apws/261103-reto-comp-andrew-grok-kicad/docs/images/261105-01 tell the agent - use tscircuit - Screenshot_20261105_011434.png

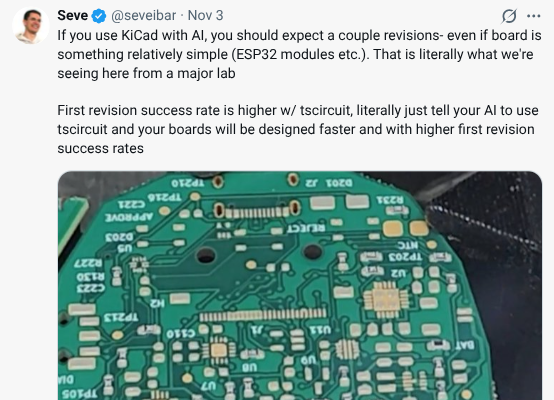
docs/images/261105-01 tell the agent - use tscircuit - Screenshot_20261105_011434.png
