apws/261103-reto-comp-andrew-grok-kicad/docs/images/261103-2328 first schematic -- Screenshot_20261103_232820.png

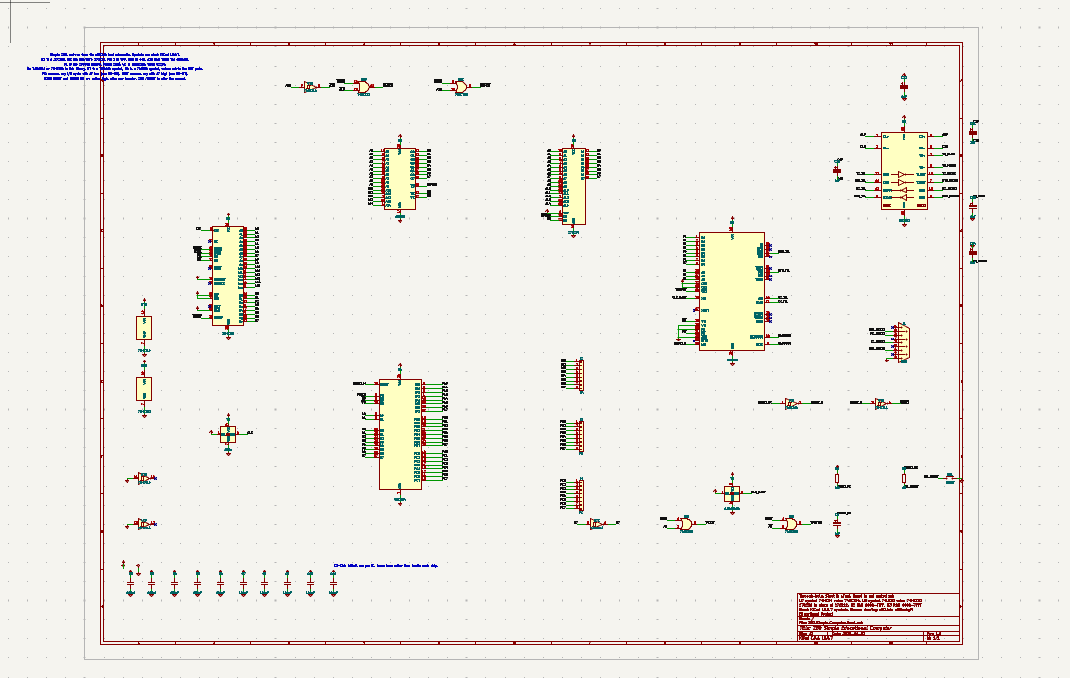
docs/images/261103-2328 first schematic -- Screenshot_20261103_232820.png
