apws/261103-reto-comp-andrew-grok-kicad/docs/images/261104-0004 very hard for grok only to relayout the sheet QQQ -- Screenshot_20261104_000429.png

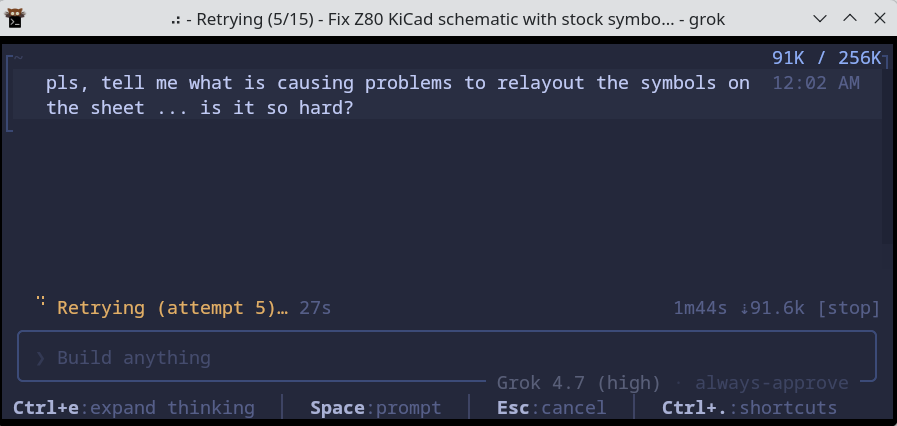
docs/images/261104-0004 very hard for grok only to relayout the sheet QQQ -- Screenshot_20261104_000429.png
