apws/261103-reto-comp-andrew-grok-kicad/docs/images/261104-0042 schematic relayout, but still large A2 sheet QQ -- Screenshot_20261104_004217.png

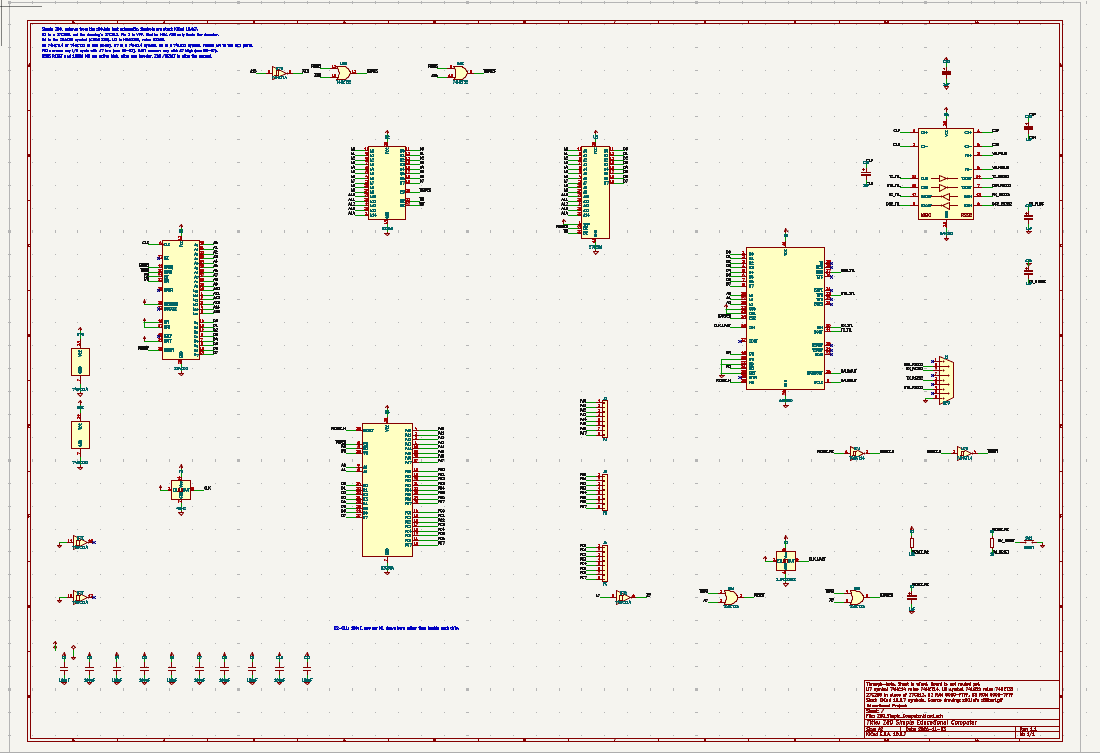
docs/images/261104-0042 schematic relayout, but still large A2 sheet QQ -- Screenshot_20261104_004217.png
