apws/261103-reto-comp-andrew-grok-kicad/docs/images/261105-00 implementing the placement and routing plan, it started but - out of weekly limit.png

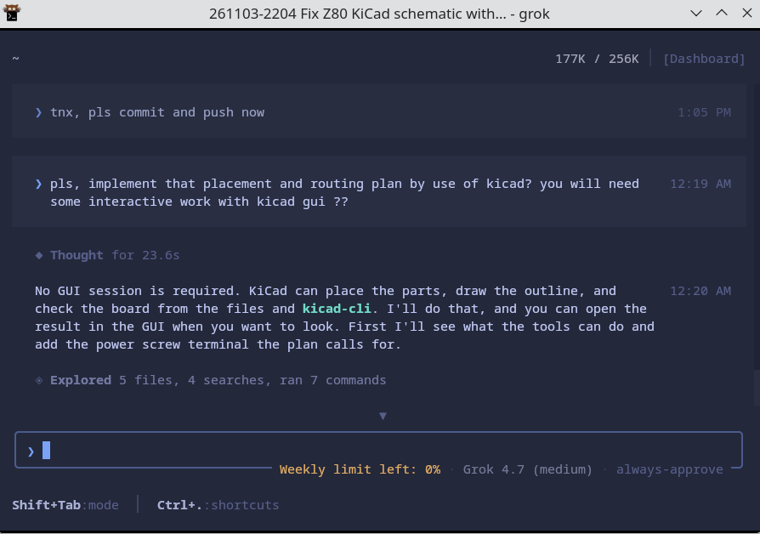
docs/images/261105-00 implementing the placement and routing plan, it started but - out of weekly limit.png
