apws/261103-reto-comp-andrew-grok-kicad/docs/images/261106-03 grok 2nd placement and 3d models in -- Screenshot_20261106_030632.png

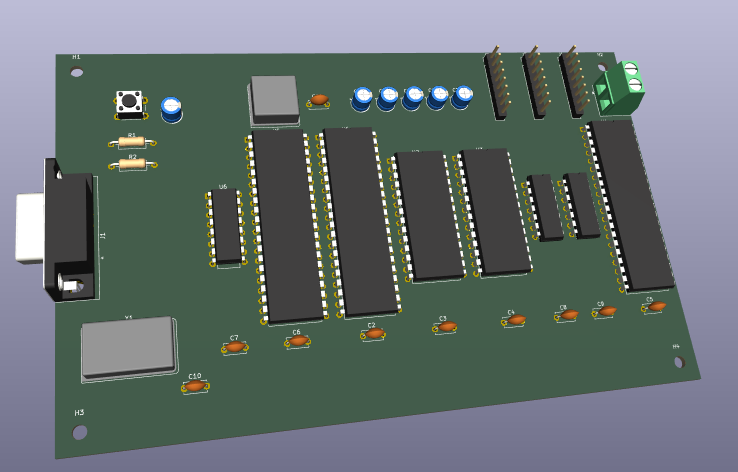
docs/images/261106-03 grok 2nd placement and 3d models in -- Screenshot_20261106_030632.png
