apws/261103-reto-comp-andrew-grok-kicad/docs/images/261106-18a google agy lauch, auth (free on google-android account QQ) -- Screenshot_20261106_190007.png

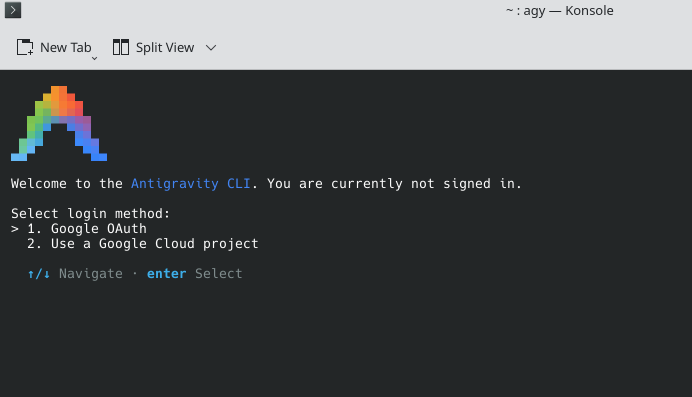
docs/images/261106-18a google agy lauch, auth (free on google-android account QQ) -- Screenshot_20261106_190007.png
