apws/261103-reto-comp-andrew-grok-kicad/docs/images/261106-18b google agy logged in -- Screenshot_20261106_190125.png

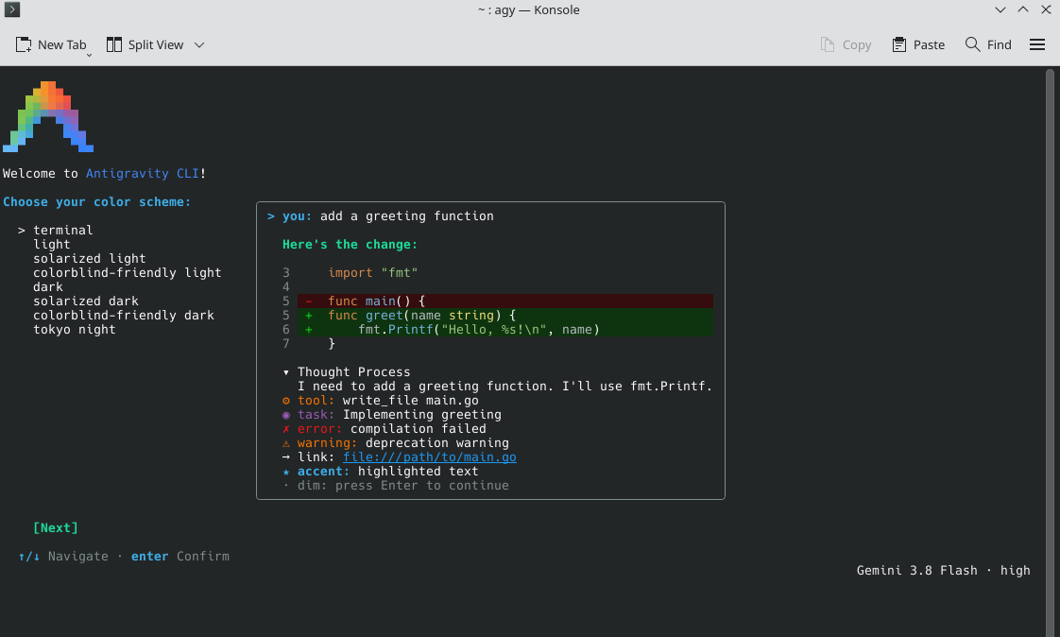
docs/images/261106-18b google agy logged in -- Screenshot_20261106_190125.png
