apws/261103-reto-comp-andrew-grok-kicad/docs/images/261106-18c google agy logged in - next config  -- Screenshot_20261106_190250.png

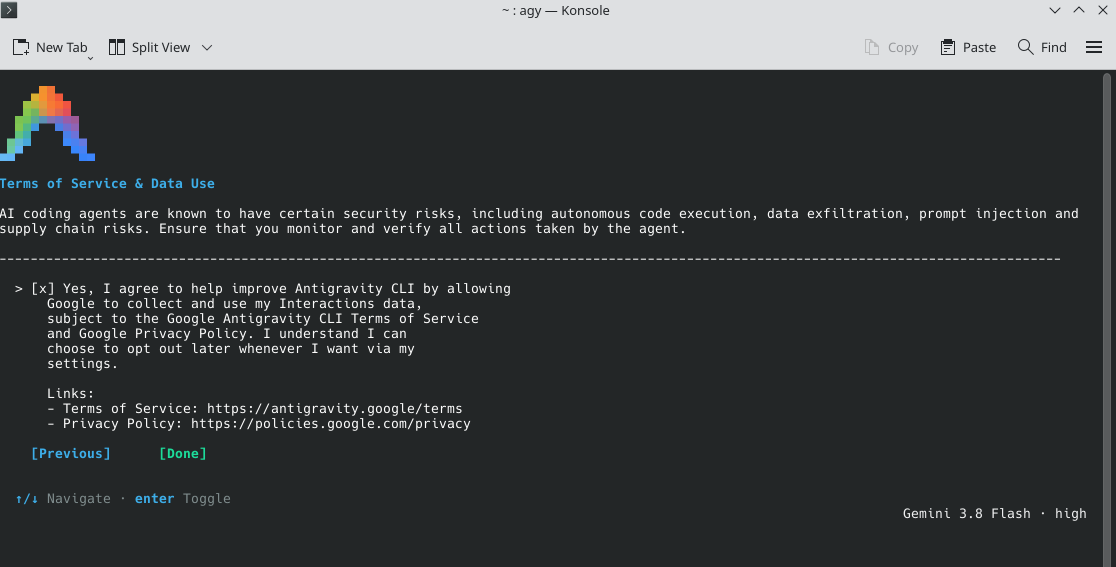
docs/images/261106-18c google agy logged in - next config -- Screenshot_20261106_190250.png
