apws/261103-reto-comp-andrew-grok-kicad/docs/images/261106-21 bottom pcb sawtooth clearance hug -- Screenshot_20261106_2139.png

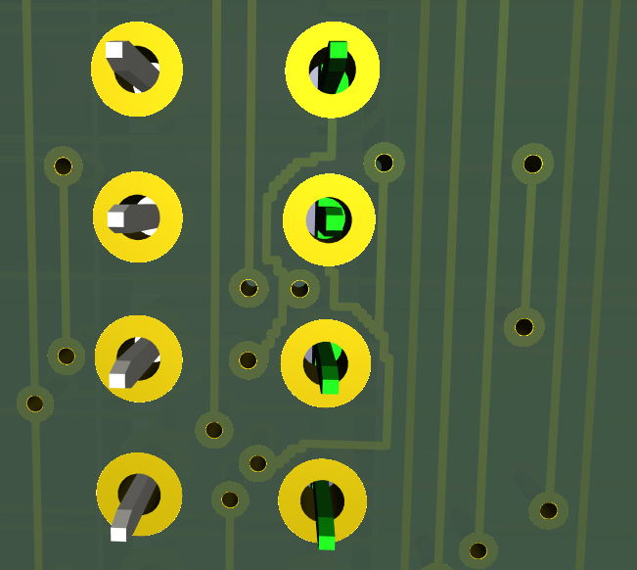
docs/images/261106-21 bottom pcb sawtooth clearance hug -- Screenshot_20261106_2139.png
