apws/261103-reto-comp-andrew-grok-kicad/docs/images/!! feilipu cpm-ide ek 8085+acia -- Screenshot_20261103_222529.png

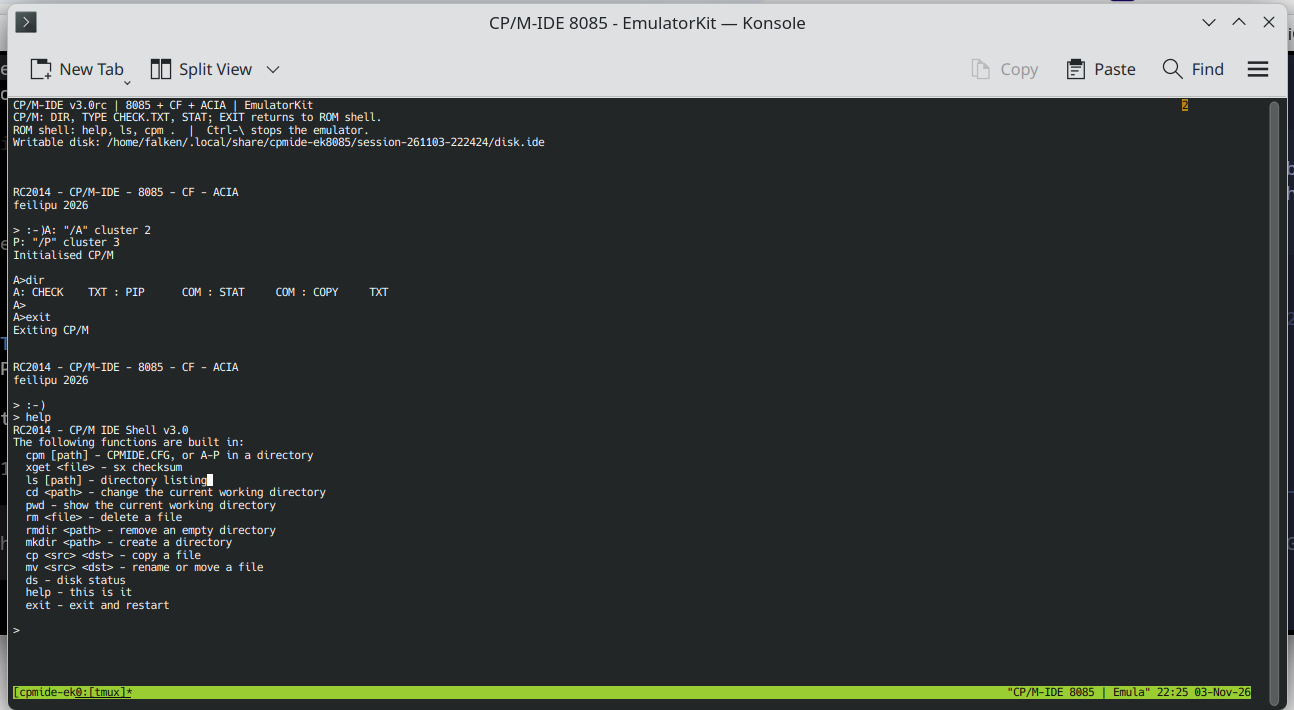
docs/images/!! feilipu cpm-ide ek 8085+acia -- Screenshot_20261103_222529.png
