apws/261103-reto-comp-andrew-grok-kicad/docs/images/!!! feilipu 8085 using EK + andrew kicad in grok - Screenshot_20261103_222328.png

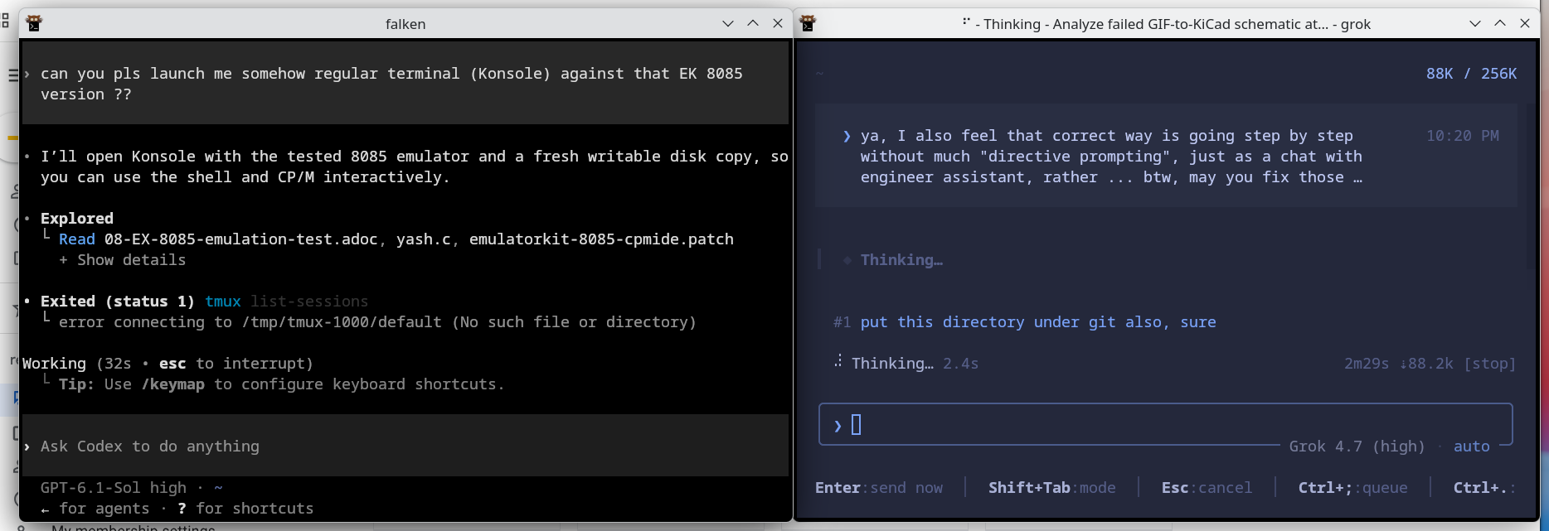
docs/images/!!! feilipu 8085 using EK + andrew kicad in grok - Screenshot_20261103_222328.png
