apws/261103-reto-comp-andrew-grok-kicad/docs/images/!!! grok in kitty, authorized by web over X -- Screenshot_20261103_220742.png

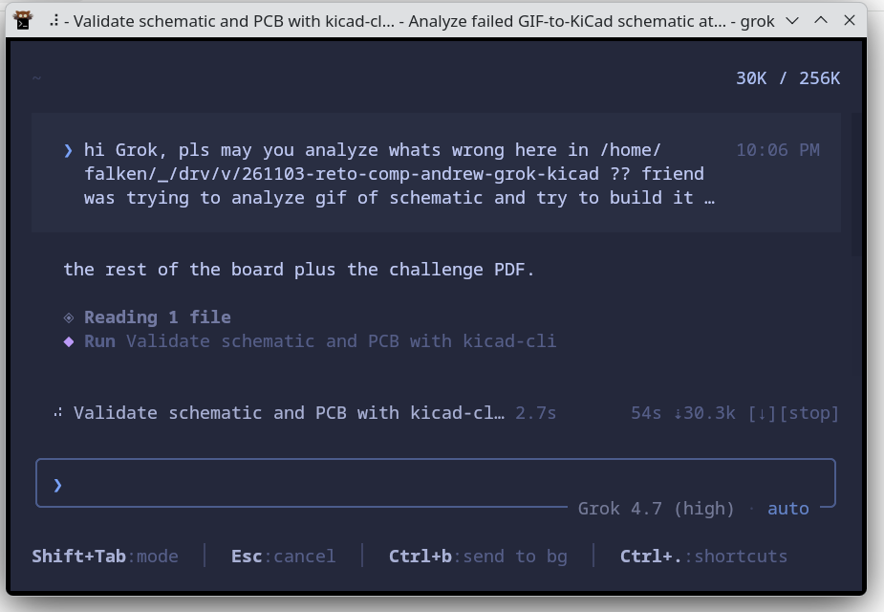
docs/images/!!! grok in kitty, authorized by web over X -- Screenshot_20261103_220742.png
