apws/261103-reto-comp-andrew-grok-kicad/docs/images/261106-18 google antigravity agy install linux -- Screenshot_20261106_185919.png

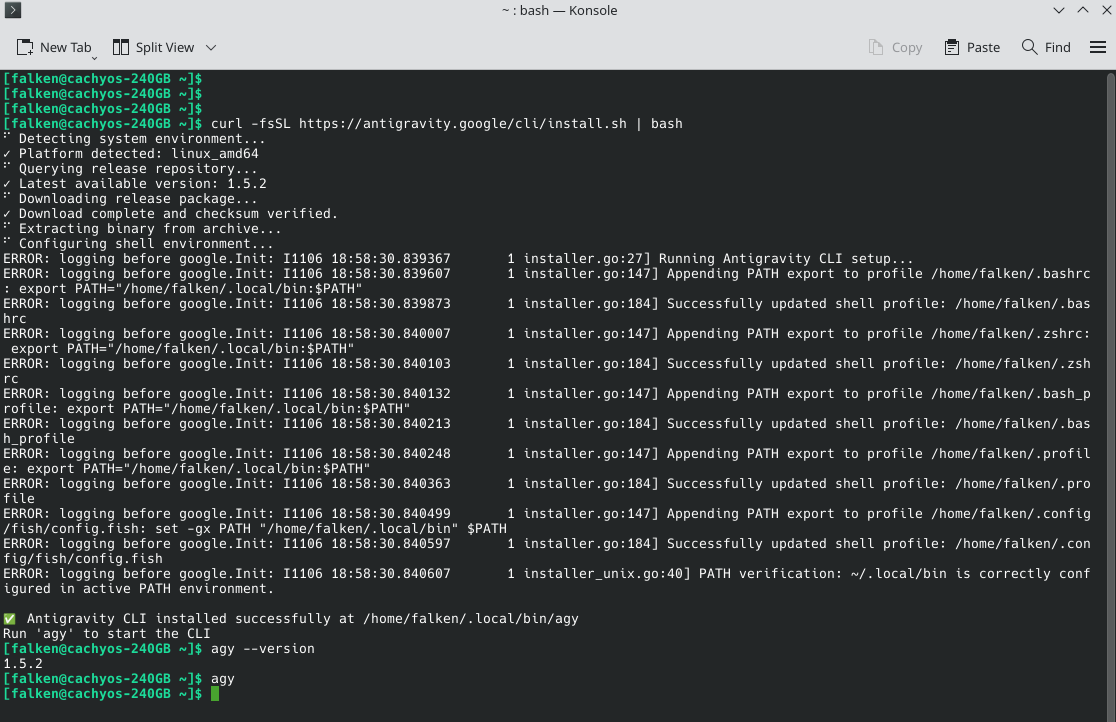
docs/images/261106-18 google antigravity agy install linux -- Screenshot_20261106_185919.png
