apws/261103-reto-comp-andrew-grok-kicad/docs/images/261106-21 google agy - Andrews board routing result (4 layer) - Screenshot_20261106_214348.png

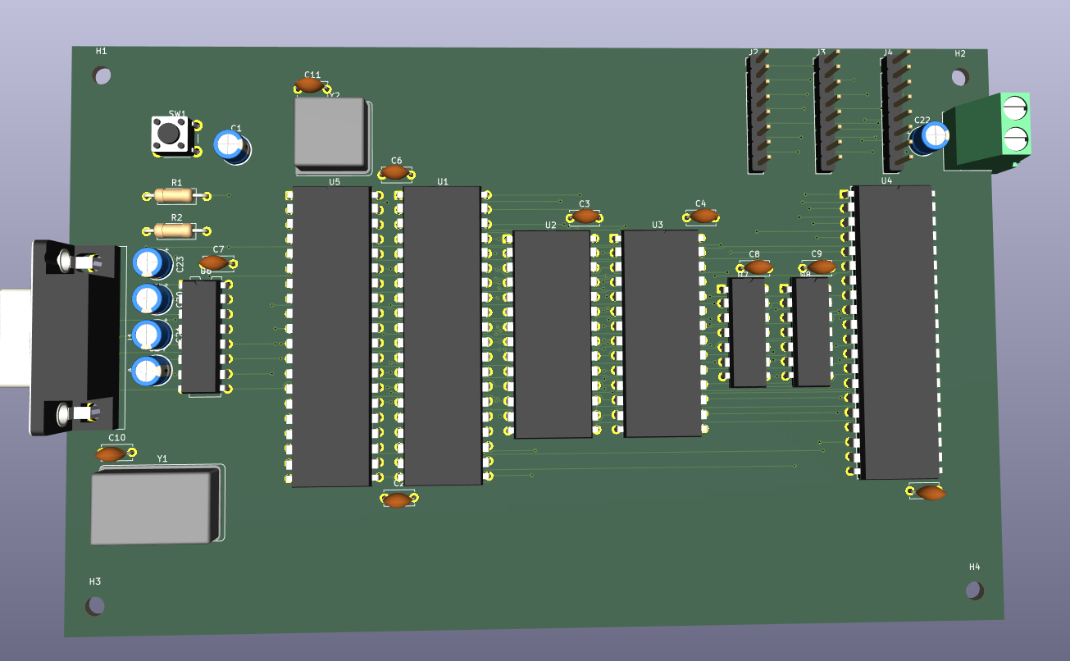
docs/images/261106-21 google agy - Andrews board routing result (4 layer) - Screenshot_20261106_214348.png
