apws/261103-reto-comp-andrew-grok-kicad/out/261105-00 schema, pcb print/261105-00 schema.pdf

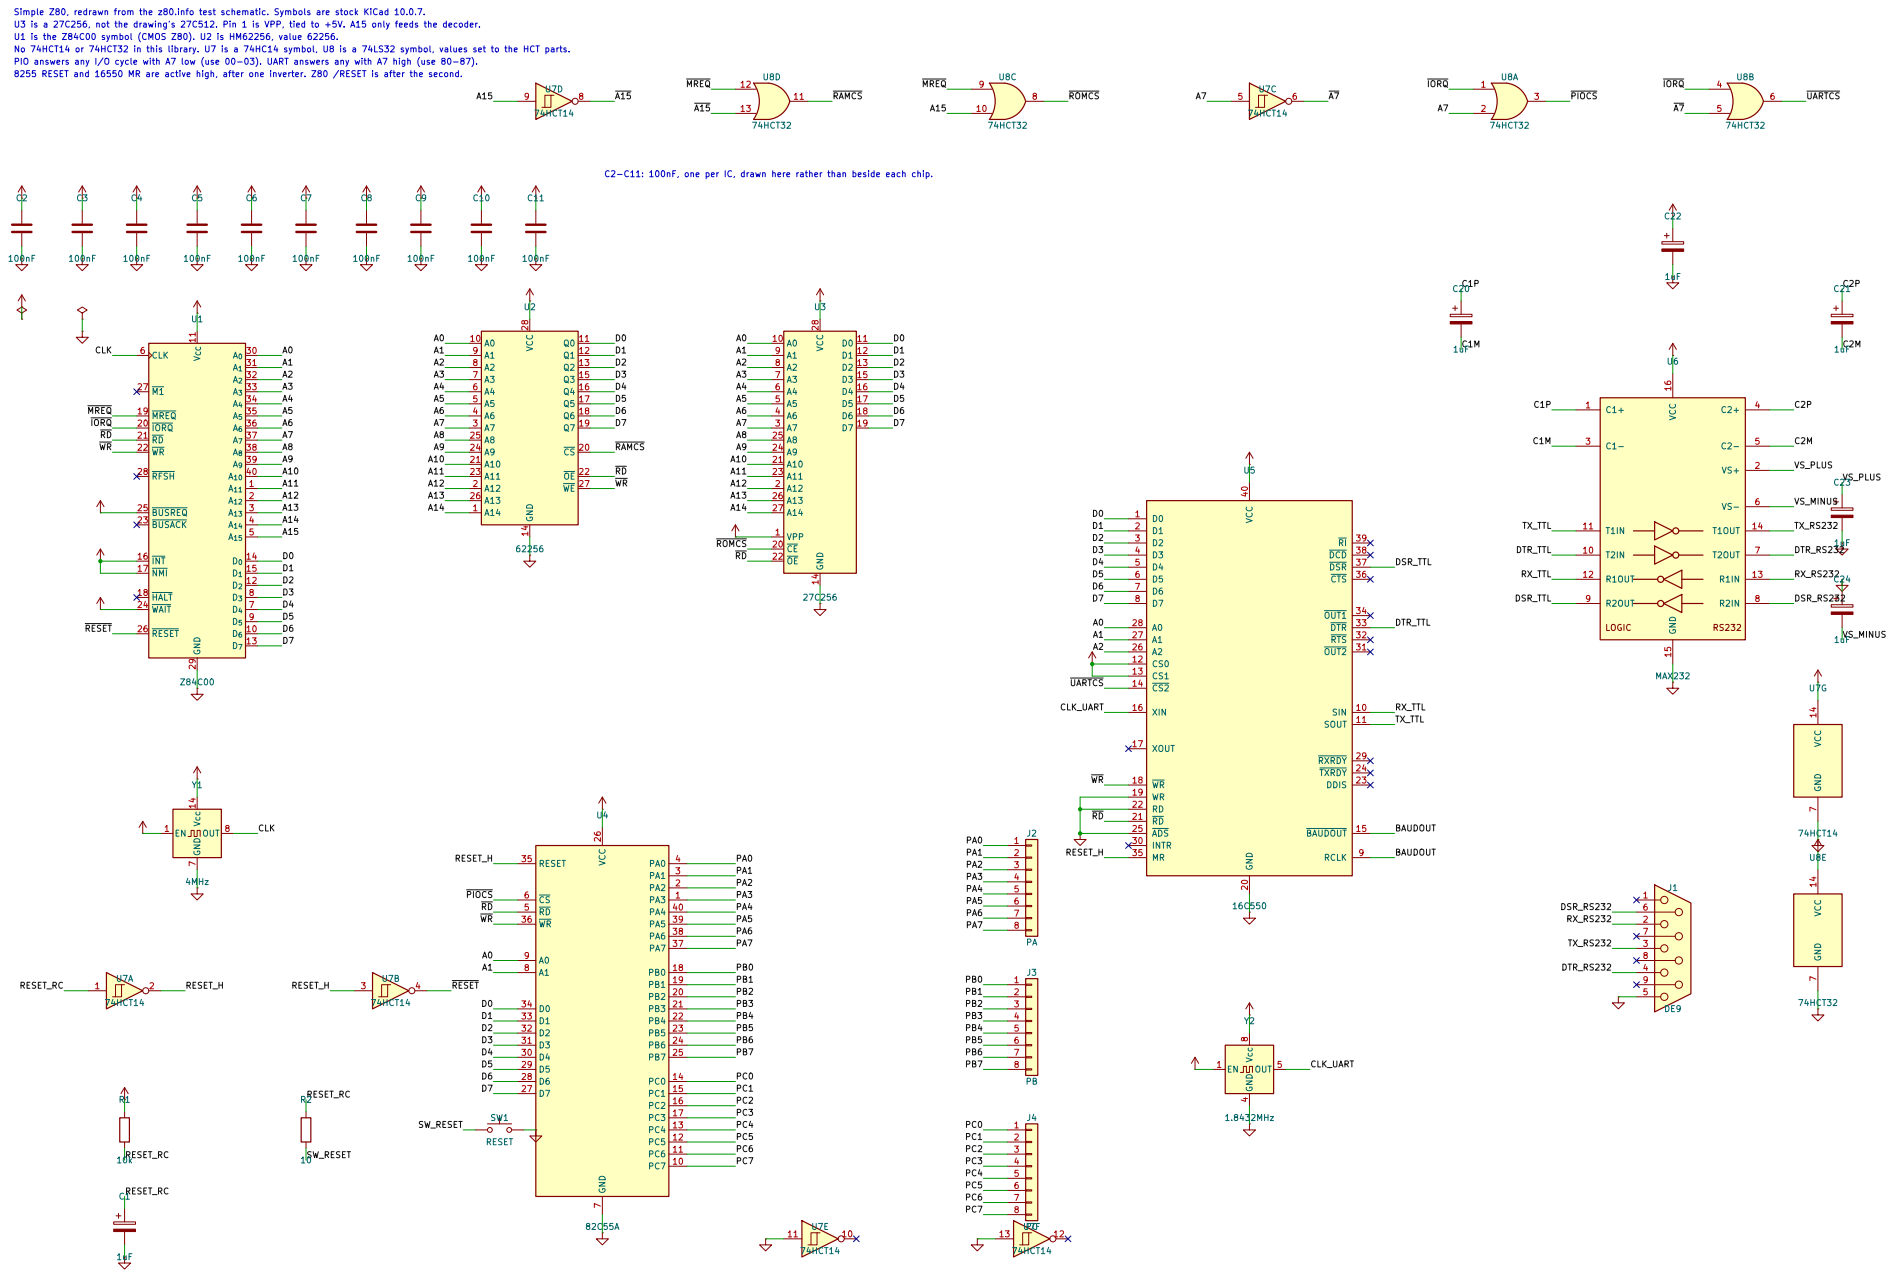
[picture p29: page 1]
