apws/261103-reto-comp-andrew-grok-kicad/Z80_Simple_Computer.kicad_pcb

## KiCad design Z80_Simple_Computer.kicad_pcb (2026-11-06)

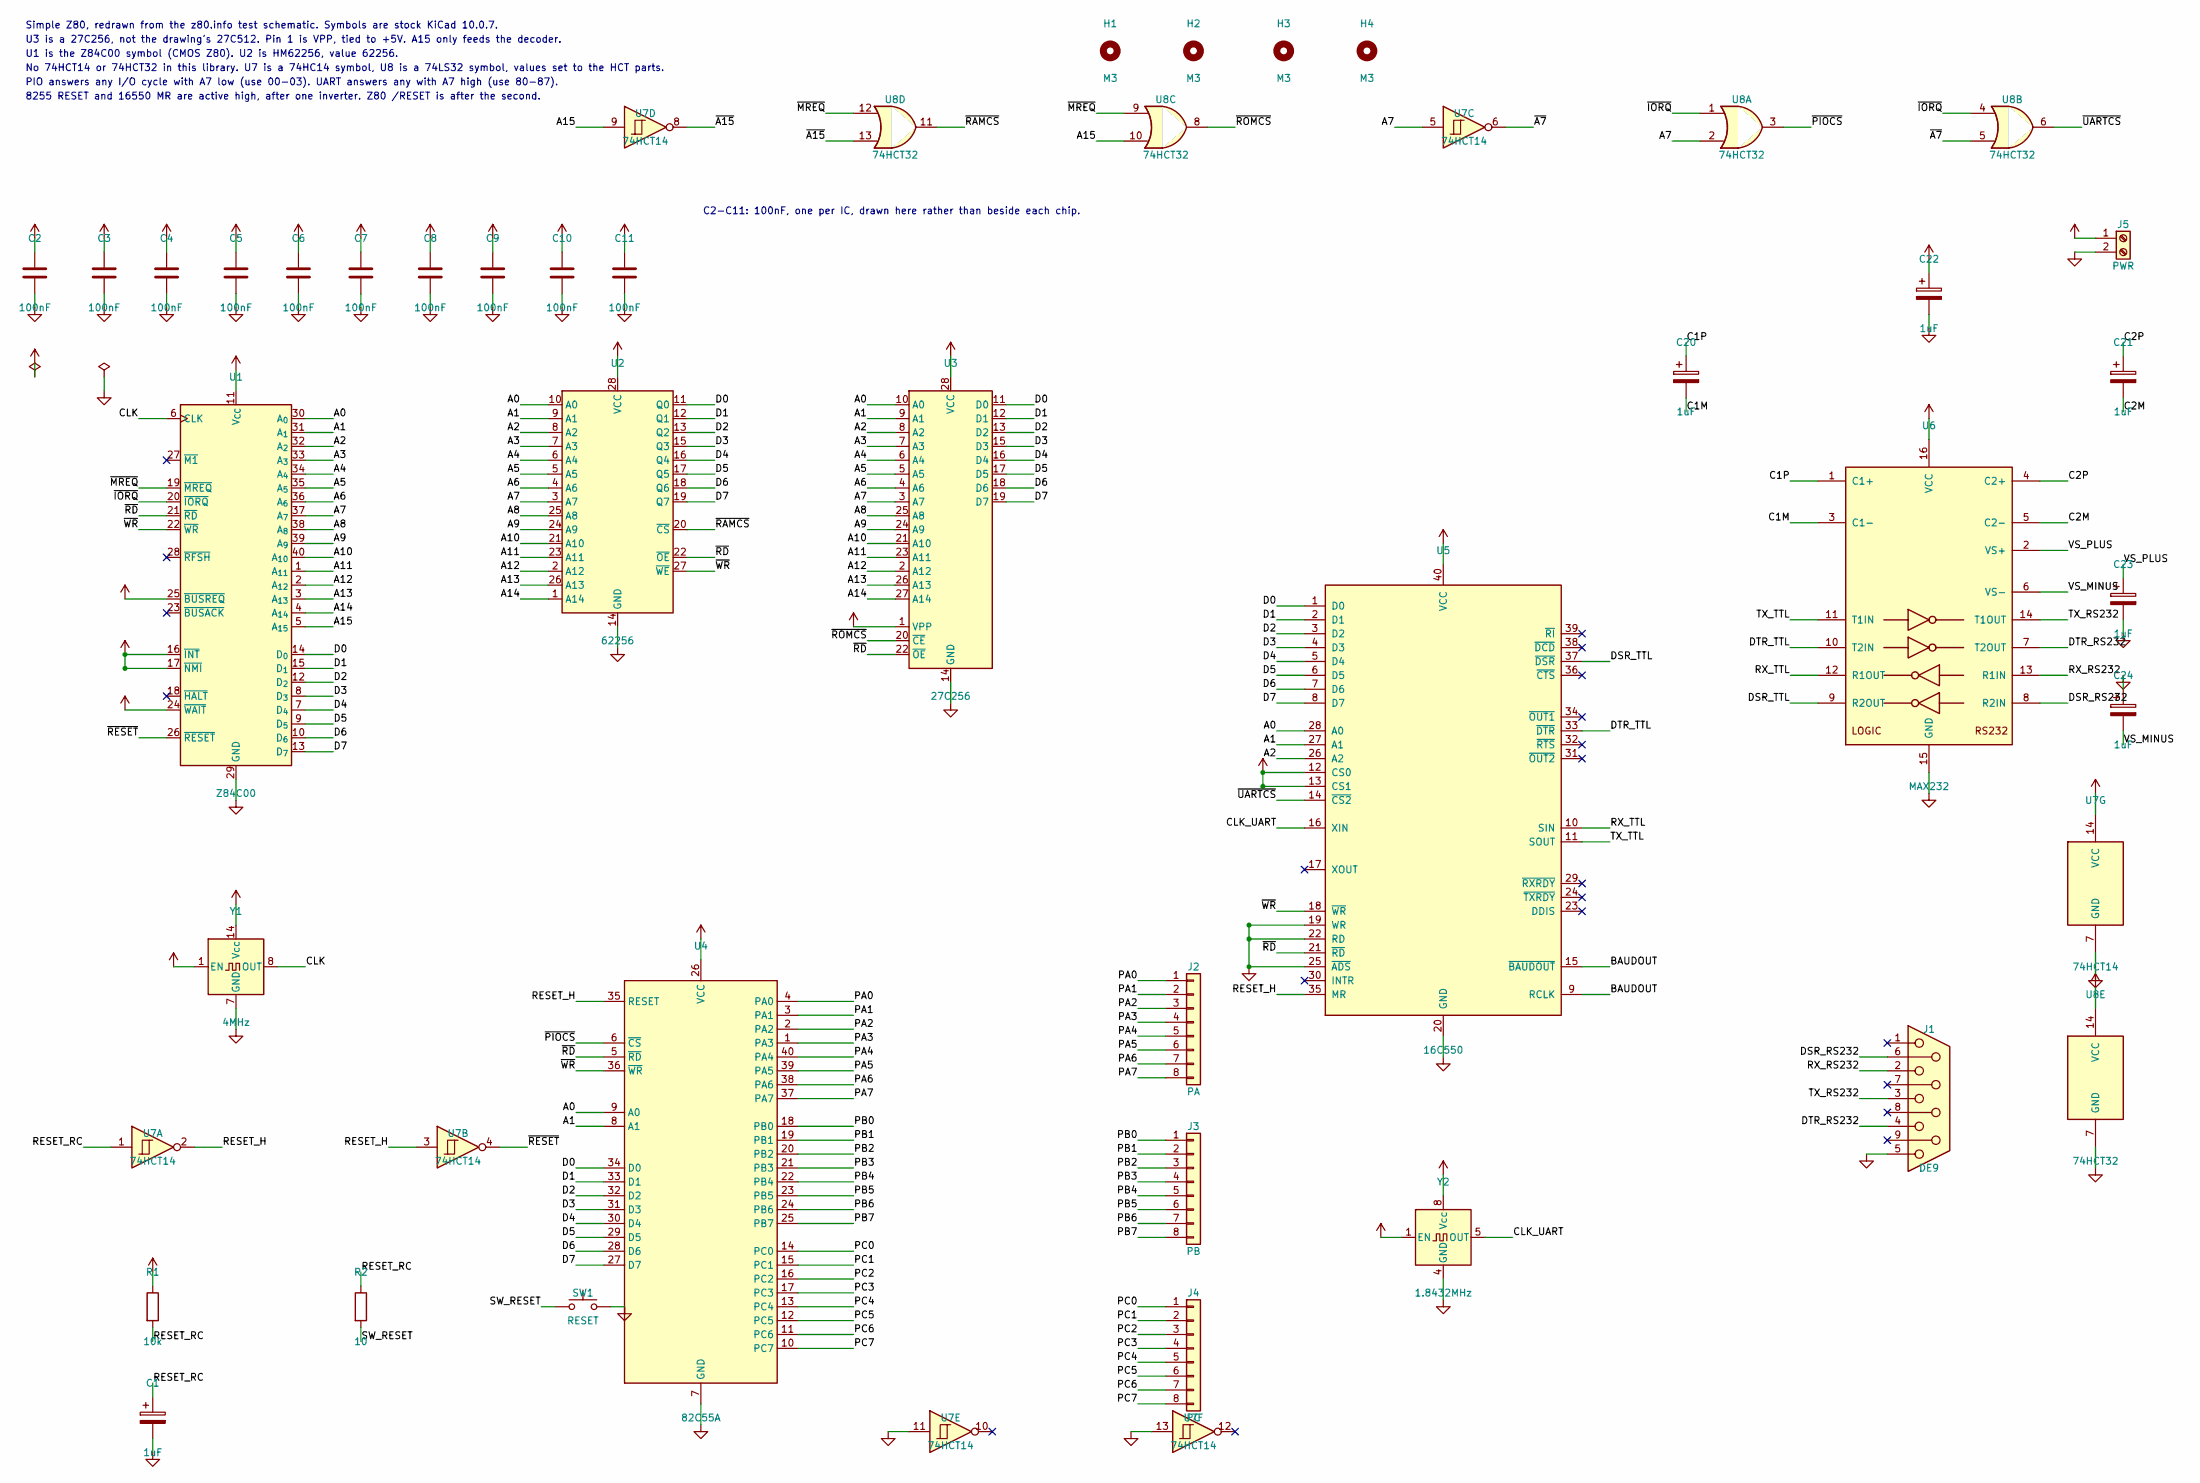
[picture p30: schematic Z80_Simple_Computer.kicad_sch, Z80 Simple Educational Computer]

Parts:
C1, C20, C21, C22, C23, C24: 1uF; CP_Radial_D5.0mm_P2.50mm
C2, C3, C4, C5, C6, C7, C8, C9, C10, C11: 100nF; C_Disc_D5.0mm_W2.5mm_P5.00mm
H1, H2, H3, H4: M3; MountingHole_3.2mm_M3
J1: DE9; DSUB-9_Socket_Horizontal_P2.77x2.84mm_EdgePinOffset4.94mm_H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
J2: PA; PinHeader_1x08_P2.54mm_Vertical
J3: PB; PinHeader_1x08_P2.54mm_Vertical
J4: PC; PinHeader_1x08_P2.54mm_Vertical
J5: PWR; TerminalBlock_Phoenix_MKDS-1,5-2-5.08_1x02_P5.08mm_Horizont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
R1: 10k; R_Axial_DIN0207_L6.3mm_D2.5mm_P10.16mm_Horizontal
R2: 10; R_Axial_DIN0207_L6.3mm_D2.5mm_P10.16mm_Horizontal
SW1: RESET; SW_PUSH_6mm
U1: Z84C00; DIP-40_W15.24mm
U2: 62256; DIP-28_W15.24mm
U3: 27C256; DIP-28_W15.24mm
U4: 82C55A; DIP-40_W15.24mm
U5: 16C550; DIP-40_W15.24mm
U6: MAX232; DIP-16_W7.62mm
U7: 74HCT14; DIP-14_W7.62mm
U8: 74HCT32; DIP-14_W7.62mm
Y1: 4MHz; Oscillator_DIP-14
Y2: 1.8432MHz; Oscillator_DIP-8

Connections:
+5V: C2.1, C3.1, C4.1, C5.1, C6.1, C7.1, C8.1, C9.1, C10.1, C11.1, C22.1, J5.1, R1.1, U1.11 (V_{CC}), U1.16 (~INT), U1.17 (~NMI), U1.24 (~WAIT), U1.25 (~BUSREQ), U2.28 (VCC), U3.1 (VPP), U3.28 (VCC), U4.26 (VCC), U5.12 (CS0), U5.13 (CS1), U5.40 (VCC), U6.16 (VCC), U7.14 (VCC), U8.14 (VCC), Y1.1 (EN), Y1.14 (Vcc), Y2.1 (EN), Y2.8 (Vcc)
/A0: U1.30 (A_{0}), U2.10 (A0), U3.10 (A0), U4.9 (A0), U5.28 (A0)
/A1: U1.31 (A_{1}), U2.9 (A1), U3.9 (A1), U4.8 (A1), U5.27 (A1)
/A2: U1.32 (A_{2}), U2.8 (A2), U3.8 (A2), U5.26 (A2)
/A3: U1.33 (A_{3}), U2.7 (A3), U3.7 (A3)
/A4: U1.34 (A_{4}), U2.6 (A4), U3.6 (A4)
/A5: U1.35 (A_{5}), U2.5 (A5), U3.5 (A5)
/A6: U1.36 (A_{6}), U2.4 (A6), U3.4 (A6)
/A7: U1.37 (A_{7}), U2.3 (A7), U3.3 (A7), U7.5, U8.2
/A8: U1.38 (A_{8}), U2.25 (A8), U3.25 (A8)
/A9: U1.39 (A_{9}), U2.24 (A9), U3.24 (A9)
/A10: U1.40 (A_{10}), U2.21 (A10), U3.21 (A10)
/A11: U1.1 (A_{11}), U2.23 (A11), U3.23 (A11)
/A12: U1.2 (A_{12}), U2.2 (A12), U3.2 (A12)
/A13: U1.3 (A_{13}), U2.26 (A13), U3.26 (A13)
/A14: U1.4 (A_{14}), U2.1 (A14), U3.27 (A14)
/A15: U1.5 (A_{15}), U7.9, U8.10
/BAUDOUT: U5.9 (RCLK), U5.15 (~BAUDOUT)
/C1M: C20.2, U6.3 (C1-)
/C1P: C20.1, U6.1 (C1+)
/C2M: C21.2, U6.5 (C2-)
/C2P: C21.1, U6.4 (C2+)
/CLK: U1.6 (CLK), Y1.8 (OUT)
/CLK_UART: U5.16 (XIN), Y2.5 (OUT)
/D0: U1.14 (D_{0}), U2.11 (Q0), U3.11 (D0), U4.34 (D0), U5.1 (D0)
/D1: U1.15 (D_{1}), U2.12 (Q1), U3.12 (D1), U4.33 (D1), U5.2 (D1)
/D2: U1.12 (D_{2}), U2.13 (Q2), U3.13 (D2), U4.32 (D2), U5.3 (D2)
/D3: U1.8 (D_{3}), U2.15 (Q3), U3.15 (D3), U4.31 (D3), U5.4 (D3)
/D4: U1.7 (D_{4}), U2.16 (Q4), U3.16 (D4), U4.30 (D4), U5.5 (D4)
/D5: U1.9 (D_{5}), U2.17 (Q5), U3.17 (D5), U4.29 (D5), U5.6 (D5)
/D6: U1.10 (D_{6}), U2.18 (Q6), U3.18 (D6), U4.28 (D6), U5.7 (D6)
/D7: U1.13 (D_{7}), U2.19 (Q7), U3.19 (D7), U4.27 (D7), U5.8 (D7)
/DSR_RS232: J1.6, U6.8 (R2IN)
/DSR_TTL: U5.37 (~DSR), U6.9 (R2OUT)
/DTR_RS232: J1.4, U6.7 (T2OUT)
/DTR_TTL: U5.33 (~DTR), U6.10 (T2IN)
/PA0: J2.1, U4.4 (PA0)
/PA1: J2.2, U4.3 (PA1)
/PA2: J2.3, U4.2 (PA2)
/PA3: J2.4, U4.1 (PA3)
/PA4: J2.5, U4.40 (PA4)
/PA5: J2.6, U4.39 (PA5)
/PA6: J2.7, U4.38 (PA6)
/PA7: J2.8, U4.37 (PA7)
/PB0: J3.1, U4.18 (PB0)
/PB1: J3.2, U4.19 (PB1)
/PB2: J3.3, U4.20 (PB2)
/PB3: J3.4, U4.21 (PB3)
/PB4: J3.5, U4.22 (PB4)
/PB5: J3.6, U4.23 (PB5)
/PB6: J3.7, U4.24 (PB6)
/PB7: J3.8, U4.25 (PB7)
/PC0: J4.1, U4.14 (PC0)
/PC1: J4.2, U4.15 (PC1)
/PC2: J4.3, U4.16 (PC2)
/PC3: J4.4, U4.17 (PC3)
/PC4: J4.5, U4.13 (PC4)
/PC5: J4.6, U4.12 (PC5)
/PC6: J4.7, U4.11 (PC6)
/PC7: J4.8, U4.10 (PC7)
/RESET_H: U4.35 (RESET), U5.35 (MR), U7.2, U7.3
/RESET_RC: C1.1, R1.2, R2.1, U7.1
/RX_RS232: J1.2, U6.13 (R1IN)
/RX_TTL: U5.10 (SIN), U6.12 (R1OUT)
/SW_RESET: R2.2, SW1.1
/TX_RS232: J1.3, U6.14 (T1OUT)
/TX_TTL: U5.11 (SOUT), U6.11 (T1IN)
/VS_MINUS: C24.2, U6.6 (VS-)
/VS_PLUS: C23.1, U6.2 (VS+)
/~A7: U7.6, U8.5
/~A15: U7.8, U8.13
/~IORQ: U1.20 (~IORQ), U8.1, U8.4
/~MREQ: U1.19 (~MREQ), U8.9, U8.12
/~PIOCS: U4.6 (~CS), U8.3
/~RAMCS: U2.20 (~CS), U8.11
/~RD: U1.21 (~RD), U2.22 (~OE), U3.22 (~OE), U4.5 (~RD), U5.21 (~RD)
/~RESET: U1.26 (~RESET), U7.4
/~ROMCS: U3.20 (~CE), U8.8
/~UARTCS: U5.14 (~CS2), U8.6
/~WR: U1.22 (~WR), U2.27 (~WE), U4.36 (~WR), U5.18 (~WR)
GND: C1.2, C2.2, C3.2, C4.2, C5.2, C6.2, C7.2, C8.2, C9.2, C10.2, C11.2, C22.2, C23.2, C24.1, J1.5, J5.2, SW1.2, U1.29 (GND), U2.14 (GND), U3.14 (GND), U4.7 (GND), U5.19 (WR), U5.20 (GND), U5.22 (RD), U5.25 (~ADS), U6.15 (GND), U7.7 (GND), U7.11, U7.13, U8.7 (GND), Y1.7 (GND), Y2.4 (GND)

Notes on the sheet:
Simple Z80, redrawn from the z80.info test schematic. Symbols are stock KiCad 10.0.7.
U3 is a 27C256, not the drawing's 27C512. Pin 1 is VPP, tied to +5V. A15 only feeds the decoder.
U1 is the Z84C00 symbol (CMOS Z80). U2 is HM62256, value 62256.
No 74HCT14 or 74HCT32 in this library. U7 is a 74HC14 symbol, U8 is a 74LS32 symbol, values set to the HCT parts.
PIO answers any I/O cycle with A7 low (use 00-03). UART answers any with A7 high (use 80-87).
8255 RESET and 16550 MR are active high, after one inverter. Z80 /RESET is after the second.
C2-C11: 100nF, one per IC, drawn here rather than beside each chip.

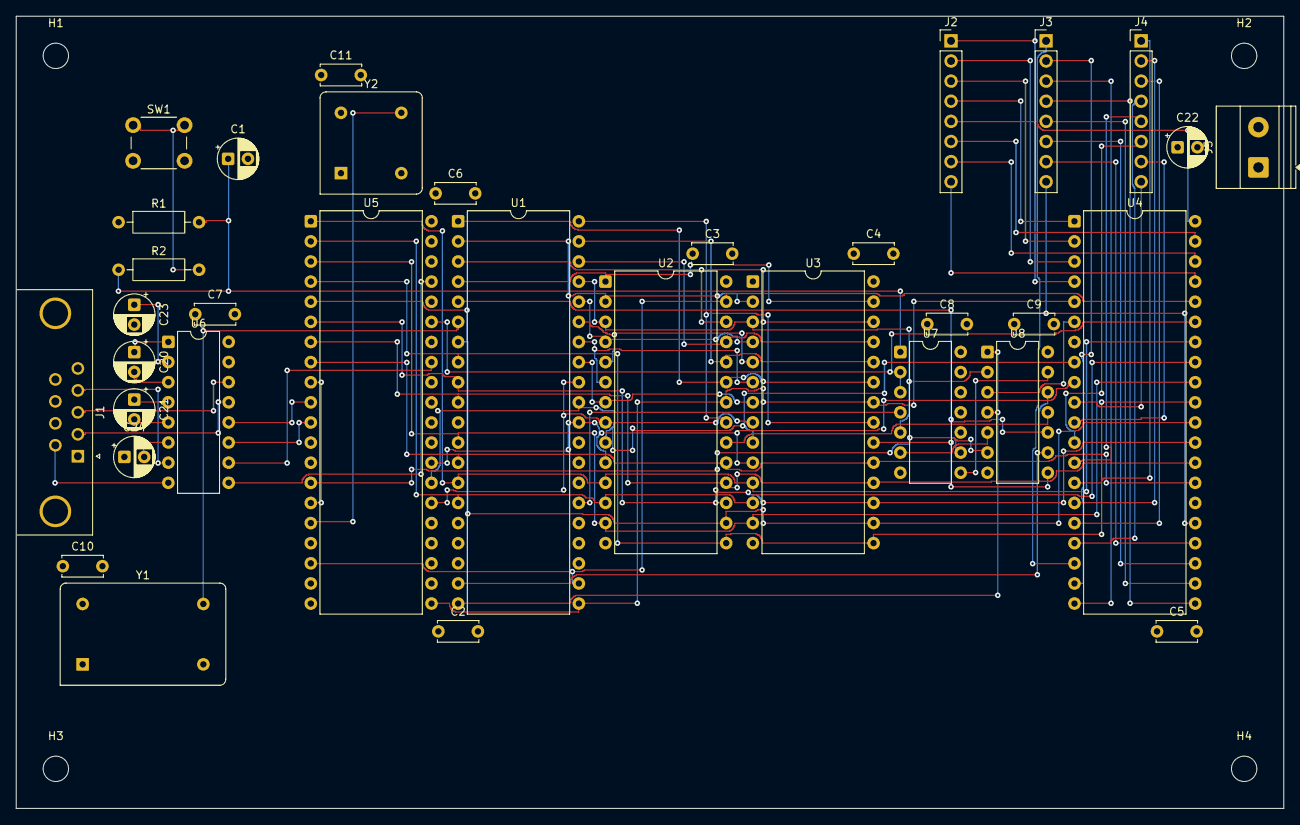
[picture p31: board Z80_Simple_Computer.kicad_pcb from above]

Board: 4 copper layers, 160.0 x 100.0 mm, 38 parts (0 on the bottom side), 81 nets.
