apws/261103-reto-comp-andrew-grok-kicad/(commit log)

2026-11-03 Track the Z80 sheet, the posted originals, and the notes.
    The schematic is rebuilt from stock KiCad 10.0.7 symbols and passes ERC.
    The board file is still the posted one and does not open.
    [Z80_Simple_Computer.kicad_pcb, Z80_Simple_Computer.kicad_sch]
2026-11-03 Say the board is still the posted file, and keep the fitted sheet.
    The schematic now sits inside the frame. The PCB has not been recreated
    and has to be steered one step at a time: size, layers, then placement.
    Notes live under docs/. The readme points at them and at the AsciiDoc preview.
    [Z80_Simple_Computer.kicad_sch]
2026-11-04 Save the KiCad 10 board KiCad wrote from the schematic.
    The project board is no longer the posted file that would not open.
    It has the 33 footprints, no board outline, and no tracks.
    The challenge PDF moves to as-posted/, and a new sheet screenshot is kept.
    KiCad's .history snapshots stay untracked.
    [Z80_Simple_Computer.kicad_pcb]
2026-11-04 Say the project board was recreated and updated from the schematic.
    It is not a repair of the posted file. That copy stays in as-posted/.
    The new board has the footprints only. Size, layers, and placement are still open.
2026-11-04 Record the board plan and the choices for the first trial.
    A4 sheet, Eurocard, four layers, a screw terminal for power, and hand
    routing in KiCad. The posted prompt file now lives with the other originals.
2026-11-04 Record the chat through the unfinished A3 page try.
    The transcript covers the board plan, the decisions, and the public repo.
    The A3 sheet is the first page step and still hangs off the paper.
    [Z80_Simple_Computer.kicad_sch]
2026-11-04 Fit the schematic on A3.
    A4 cannot hold the DIP-40 symbols. The same nets now sit inside the A3 frame.
    [Z80_Simple_Computer.kicad_sch]
2026-11-05 Place the Eurocard and vendor the 3D models.
    The sheet now has the screw terminal and the four mounting holes. The board is the 160 by 100 mm placement, with the DE9 and the screw terminal facing out, inner planes, and no signal tracks. JLCPCB clearances are in the project, and the STEP models the footprints name are included.
    [Z80_Simple_Computer.kicad_pcb, Z80_Simple_Computer.kicad_sch]
2026-11-05 Point the 3D models at the project libs folder.
    The stock KICAD10_3DMODEL_DIR path stayed red because this machine has no system 3D library. The board and the vendored footprints now use KIPRJMOD.
    [Z80_Simple_Computer.kicad_pcb]
2026-11-06 Refine Eurocard placement and record the design brief.
    Turn the screw terminal outward, bring bypass and charge-pump capacitors closer to their pins, and move the MAX232 beside the DE9. Update the placement script and notes, and preserve the screenshot and Lyra chat PDF. The board remains placement-only with no signal tracks.
    [Z80_Simple_Computer.kicad_pcb]
2026-11-06 Route all signal nets on 4-layer Eurocard and record routing notes.
    Complete 100% automated routing of the Z80 Simple Computer board using
    an in-tree Manhattan A* router via KiCad's pcbnew API (tools/route_netgroup.py).
    Passes KiCad DRC with 0 unconnected items, 0 clearance errors, 0 shorts,
    and 0 schematic parity issues across all 7 net groups. Document the grok-cli
    to Antigravity (agy) handover, routing methodology, and trace geometry in docs/.
    [Z80_Simple_Computer.kicad_pcb]
